airtoall/papr-eletrical/4-mill-vent/Pictures/4-mill-vent-back_parts.jpg

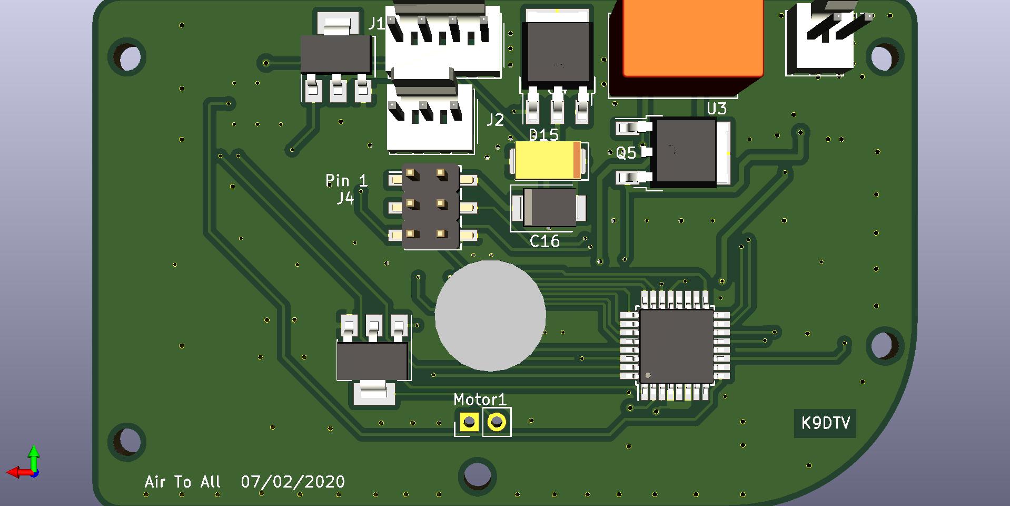
4-mill-vent/Pictures/4-mill-vent-back_parts.jpg
