airtoall/papr-eletrical/4-mill-vent/Pictures/4-mill-vent-front_parts.jpg

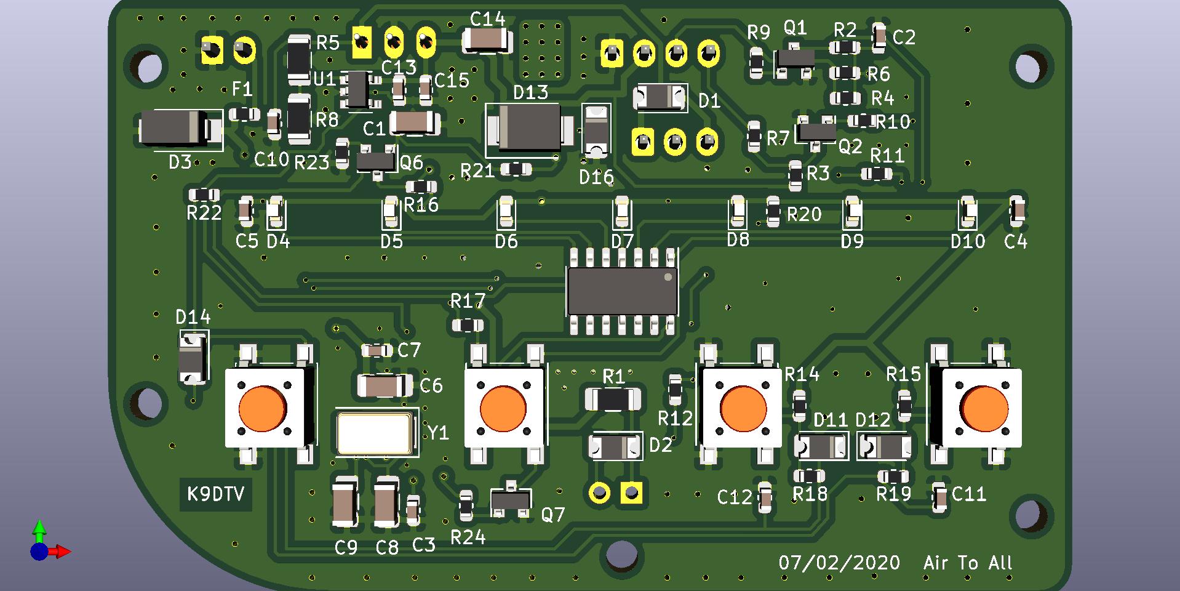
4-mill-vent/Pictures/4-mill-vent-front_parts.jpg
