airtoall/papr-eletrical/4-mill-vent/Pictures/20200725_114623.jpg

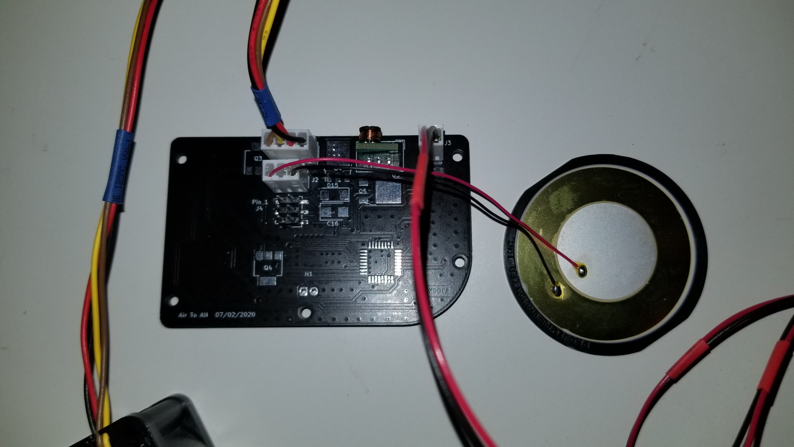
4-mill-vent/Pictures/20200725_114623.jpg
