airtoall/papr-eletrical/4-mill-vent/Pictures/20200802_105255.jpg

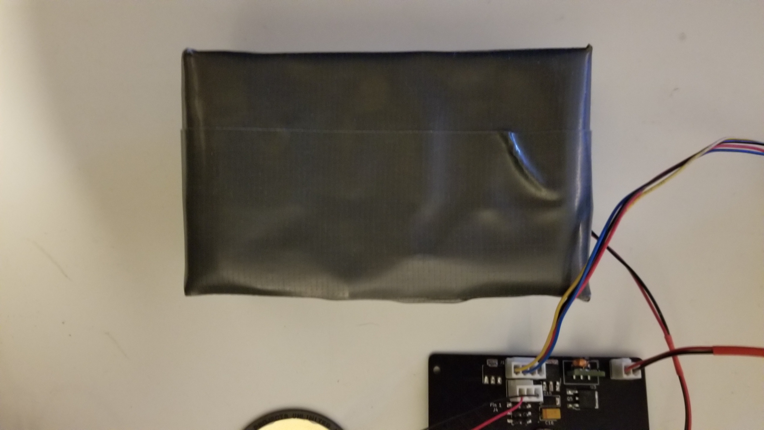
4-mill-vent/Pictures/20200802_105255.jpg
