airtoall/papr-eletrical/4-mill-vent/schematics-bom/ATA_PCBA_V3_Leadtime_Stock_Review - 12-11-2020.xlsx

Customer Reference | Vendor Part Number | Stock | Leadtime ( Weeks ) | Manufacturer Part Number | Description | Proposed Substitutes | Comments | Leadtime
ATA_0011 | 0713080492-ND | 0 | 12 | 0713080492 | CONN HEADER SMD 92POS 2.54MM | Digikey has in stock is 6-146134-5-ND, which is similar except 80 positions. |  | As of november 22, product leadtime is to be deliverded on February 2
ATA_0001 | 105-03PMFS-SC7001-ND | 0 | 6 | 105-03PMFS-SC7001 | M 10.5 CONN | Digikey Part 952-1631-ND | Proposed substitute is functionally similar. It's about 5mm larger in diameter though, so that may be a mechanical fit issue. Panel cutout for the original part is 10.0mm and the overall diameter including the hex nut is 17.3mm. Braulio called distributor for the amphenol susbtitute. | As of november 22, product leadtime is to be delivered on January 1
ATA_0040 | 296-47075-ND | 300 | 8 | TPSM84212EAB | DC DC CONVERTER 12V
ATA_0042 | VLMY1300-GS08CT-ND | 300 | 10 | VLMY1300-GS08 | LED YELLOW 0603 SMD |  | as of november 22, the leadtimes are (paste from Brent's email) january 4
ATA_0002 | 478-1471-1-ND | 500 | 12 | 12065A180JAT2A | CAP CER 18PF 50V C0G/NP0 1206
ATA_0012 | 668-1190-ND | 900 | 13 | APS4812B-LW100-R | BUZZER ELEMENT STD 1.2KHZ 50MM
ATA_0028 | RHM300ZCT-ND | 1400 | 10 | LTR18EZPJ301 | RES SMD 300 OHM 3/4W 1206 WIDE
ATA_0041 | TSM480P06CPROGCT-ND | 1500 | 20 | TSM480P06CP ROG | MOSFET P-CHANNEL 60V 20A TO252
ATA_0010 | 652-4814P-1LF-330 | 1600 | 7 | 4814P-1-331LF | RES ARRAY 7 RES 330 OHM 14SOIC
ATA_0017 | XC3086CT-ND | 1800 | 9 | ECS-160-18-23B-JTM-TR | CRYSTAL 16.0000MHZ 18PF SMD | ECS-160-18-23A-JGN-TR | Proposed substitute is the same as what's on the BOM now, just 2 pins instead of 4. Height is the same.
ATA_0025 | LM1117DTX-5.0/NOPBCT-ND | 2000 | 6 | LM1117DTX-5.0/NOPB | IC REG LINEAR 5V 800MA TO252-3
ATA_0039 | 511-TCTAL1V335M8RDKR-ND | 2900 | 8 | TCTAL1V335M8R | CAP TANT 3.3UF 20% 35V 1206
ATA_0026 | 296-51261-1-ND | 3000 | 6 | LM321LVIDBVR | IC OPAMP GP 1 CIRCUIT SOT23-5
ATA_0037 | 67-2332-1-ND | 4000 | 14 | SML-LXIL0603UPGCTR | 1.64X0.84X1.15MM TOP VIEW SMT LE
ATA_0019 | P560KBZCT-ND | 4000 | 19 | ERJ-PA3J564V | RES SMD 560K OHM 5% 1/4W 0603
ATA_0034 | RNCP1206FTD14K0CT-ND | 4500 | 18 | RNCP1206FTD14K0 | RES 14K OHM 1% 1/2W 1206
ATA_0032 | 541-2820-1-ND | 5000 | 32 | RCS0603100KJNEA | RES SMD 100K OHM 5% 1/4W 0603
ATA_0020 | RHM220KDCT-ND | 6000 | 10 | ESR03EZPJ224 | RES SMD 220K OHM 5% 1/4W 0603
ATA_0033 | 541-2814-1-ND | 7000 | 32 | RCS06031K00JNEA | RES SMD 1K OHM 5% 1/4W 0603
ATA_0035 | RNCP1206FTD75K0CT-ND | 7500 | 18 | RNCP1206FTD75K0 | RES 75K OHM 1% 1/2W 1206
ATA_0027 | 587-6340-1-ND | 8000 | 17 | LMK316AB7106MLHT | CAP CER 10UF 10V X7R 1206
ATA_0021 | RHM820KDCT-ND | 8000 | 10 | ESR03EZPJ824 | RES SMD 820K OHM 5% 1/4W 0603
ATA_0009 | 538-22-23-2042 | 10000 | 12 | 0022232042 | CONN HEADER VERT 4POS 2.54MM
ATA_0016 | 541-10KSACT-ND | 12000 | 18 | CRCW060310K0JNEAHP | RES SMD 10K OHM 5% 1/4W 0603
ATA_0036 | SMBJ5362B-TPMSCT-ND | 14000 | 12 | SMBJ5362B-TP | DIODE ZENER 28V 5W DO214AA
ATA_0008 | WM22764-ND | 15000 | 13 | 22232037 | CONN HEADER VERT 3POS 2.54MM
ATA_0014 | ATMEGA328P-AU-ND | 16000 | 9 | ATMEGA328P-AU | IC MCU 8BIT 32KB FLASH 32TQFP
ATA_0007 | WM19468-ND | 18000 | 8 | 0022232023 | CONN HEADER VERT 2POS 2.54MM
ATA_0018 | P330BZCT-ND | 19000 | 19 | ERJ-PA3J331V | RES SMD 330 OHM 5% 1/4W 0603
ATA_0038 | 399-8339-1-ND | 27000 | 7 | T491C107M006AT | CAP TANT 100UF 20% 6.3V 2312
ATA_0013 | 754-1804-1-ND | 30000 | 12 | APTD1608VBC/D | LED BLUE CLEAR CHIP SMD
ATA_0031 | PZT3904T1GOSCT-ND | 31000 | 8 | PZT3904T1G | TRANS NPN 40V 0.2A SOT223
ATA_0030 | CKN9084CT-ND | 85000 | 16 | PTS645SK43SMTR92 LFS | SWITCH TACTILE SPST-NO 0.05A 12V
ATA_0029 | MMBT3904-TP | 95000 | 12 | MMBT3904-TP | TRANS NPN 40V 0.2A SOT23
ATA_0015 | 399-1099-1-ND | 176000 | 8 | C0603C104M4RACTU | CAP CER 0.1UF 16V X7R 0603
