airtoall/papr-eletrical/4-mill-vent/schematics-bom/BOM-v1.xlsx

Part | Description | Package | Part Number | Link to part | Data Sheet
C1 | Multilayer Ceramic Capacitors MLCC - SMD/SMT 16V 0.1uF 0603 X7R 20% | SMD:C 0603 1608 Metric | C0603C104M4RACTU | https://www.mouser.com/ProductDetail/KEMET/C0603C104M4RACTU?qs=jZ42y6hXG8n1McOj%2FlAJug%3D%3D | http://ksim.kemet.com/Plots/SpicePlots.aspx
C2 | Multilayer Ceramic Capacitors MLCC - SMD/SMT 16V 0.1uF 0603 X7R 20% | SMD:C 0603 1608 Metric | C0603C104M4RACTU | https://www.mouser.com/ProductDetail/KEMET/C0603C104M4RACTU?qs=jZ42y6hXG8n1McOj%2FlAJug%3D%3D | http://ksim.kemet.com/Plots/SpicePlots.aspx
C3 | Multilayer Ceramic Capacitors MLCC - SMD/SMT 16V 0.1uF 0603 X7R 20% | SMD:C 0603 1608 Metric | C0603C104M4RACTU | https://www.mouser.com/ProductDetail/KEMET/C0603C104M4RACTU?qs=jZ42y6hXG8n1McOj%2FlAJug%3D%3D | http://ksim.kemet.com/Plots/SpicePlots.aspx
C4 | Multilayer Ceramic Capacitors MLCC - SMD/SMT 16V 0.1uF 0603 X7R 20% | SMD:C 0603 1608 Metric | C0603C104M4RACTU | https://www.mouser.com/ProductDetail/KEMET/C0603C104M4RACTU?qs=jZ42y6hXG8n1McOj%2FlAJug%3D%3D | http://ksim.kemet.com/Plots/SpicePlots.aspx
C5 | Multilayer Ceramic Capacitors MLCC - SMD/SMT 16V 0.1uF 0603 X7R 20% | SMD:C 0603 1608 Metric | C0603C104M4RACTU | https://www.mouser.com/ProductDetail/KEMET/C0603C104M4RACTU?qs=jZ42y6hXG8n1McOj%2FlAJug%3D%3D | http://ksim.kemet.com/Plots/SpicePlots.aspx
C6 | Multilayer Ceramic Capacitors MLCC - SMD/SMT 1206 10VDC 10uF 20% X7R | SMD:C 1206 3216 Metric | LMK316AB7106MLHT | https://www.mouser.com/ProductDetail/Taiyo-Yuden/LMK316AB7106MLHT | https://www.mouser.com/datasheet/2/396/taiyo_yuden_12132018_mlcc11_hq_e-1510082.pdf
C7 | Multilayer Ceramic Capacitors MLCC - SMD/SMT 16V 0.1uF 0603 X7R 20% | SMD:C 0603 1608 Metric | C0603C104M4RACTU | https://www.mouser.com/ProductDetail/KEMET/C0603C104M4RACTU?qs=jZ42y6hXG8n1McOj%2FlAJug%3D%3D | http://ksim.kemet.com/Plots/SpicePlots.aspx
C8 | Multilayer Ceramic Capacitors MLCC - SMD/SMT 18pF NPO | SMD:C 1206 3216 Metric | 1206Y0160180FFT | https://www.mouser.com/ProductDetail/Knowles-Syfer/1206Y0160180FFT | https://www.mouser.com/datasheet/2/218/IECQ-CECCDatasheet-1509637.pdf
C9 | Multilayer Ceramic Capacitors MLCC - SMD/SMT 18pF NPO | SMD:C 1206 3216 Metric | 1206Y0160180FFT | https://www.mouser.com/ProductDetail/Knowles-Syfer/1206Y0160180FFT | https://www.mouser.com/datasheet/2/218/IECQ-CECCDatasheet-1509637.pdf
C10 | Multilayer Ceramic Capacitors MLCC - SMD/SMT 16V 0.1uF 0603 X7R 20% | SMD:C 0603 1608 Metric | C0603C104M4RACTU | https://www.mouser.com/ProductDetail/KEMET/C0603C104M4RACTU?qs=jZ42y6hXG8n1McOj%2FlAJug%3D%3D | http://ksim.kemet.com/Plots/SpicePlots.aspx
C11 | Multilayer Ceramic Capacitors MLCC - SMD/SMT 16V 0.1uF 0603 X7R 20% | SMD:C 0603 1608 Metric | C0603C104M4RACTU | https://www.mouser.com/ProductDetail/KEMET/C0603C104M4RACTU?qs=jZ42y6hXG8n1McOj%2FlAJug%3D%3D | http://ksim.kemet.com/Plots/SpicePlots.aspx
C12 | Multilayer Ceramic Capacitors MLCC - SMD/SMT 16V 0.1uF 0603 X7R 20% | SMD:C 0603 1608 Metric | C0603C104M4RACTU | https://www.mouser.com/ProductDetail/KEMET/C0603C104M4RACTU?qs=jZ42y6hXG8n1McOj%2FlAJug%3D%3D | http://ksim.kemet.com/Plots/SpicePlots.aspx
C13 | Solid SMD Tantalum Capacitors - 3.3uf 36V | SMD:C 1206 3216 Metric | TCTAL1V335M8R | https://www.mouser.com/ProductDetail/ROHM-Semiconductor/TCTAL1V335M8R | https://www.mouser.com/datasheet/2/348/tct_al-e-1874581.pdf
C14 | Multilayer Ceramic Capacitors MLCC - SMD/SMT 1206 10VDC 10uF 20% X7R | SMD:C 1206 3216 Metric | LMK316AB7106MLHT | https://www.mouser.com/ProductDetail/Taiyo-Yuden/LMK316AB7106MLHT | https://www.mouser.com/datasheet/2/396/taiyo_yuden_12132018_mlcc11_hq_e-1510082.pdf
C15 | Multilayer Ceramic Capacitors MLCC - SMD/SMT 16V 0.1uF 0603 X7R 20% | SMD:C 0603 1608 Metric | C0603C104M4RACTU | https://www.mouser.com/ProductDetail/KEMET/C0603C104M4RACTU?qs=jZ42y6hXG8n1McOj%2FlAJug%3D%3D | http://ksim.kemet.com/Plots/SpicePlots.aspx
C16 | Tantalum Capacitors - Solid SMD 6.3V 100.uF 2312 20% ESR=900mOhms | SMD:CP-EIA 6032-15 | T491C107M006AT | https://www.mouser.com/ProductDetail/KEMET/T491C107M006AT?qs=qfhfvpM3tgiD6Stt3RzjFA%3D%3D | https://www.mouser.com/datasheet/2/212/1/KEM_T2005_T491-1093550.pdf
C17 | Multilayer Ceramic Capacitors MLCC - SMD/SMT 16V 0.1uF 0603 X7R 20% | SMD:C 0603 1608 Metric | C0603C104M4RACTU | https://www.mouser.com/ProductDetail/KEMET/C0603C104M4RACTU?qs=jZ42y6hXG8n1McOj%2FlAJug%3D%3D | http://ksim.kemet.com/Plots/SpicePlots.aspx
D1 | General Purpose, Power, Switching Switching diode 400 mW | SMD:D SOD-123F | 1N914BW RH | https://www.mouser.com/ProductDetail/Taiwan-Semiconductor/1N914BW-RH?qs=SikLhao2tv9CkM7MAcUvqA%3D%3D | https://www.mouser.com/datasheet/2/395/1N4148W_SERIES_K1804-1519318.pdf
D2 | General Purpose, Power, Switching Switching diode 400 mW | SMD:D SOD-123F | 1N914BW RH | https://www.mouser.com/ProductDetail/Taiwan-Semiconductor/1N914BW-RH?qs=SikLhao2tv9CkM7MAcUvqA%3D%3D | https://www.mouser.com/datasheet/2/395/1N4148W_SERIES_K1804-1519318.pdf
D3 | Zener 28V 5W | DO-214AA-2 | SMBJ5362B-TP | https://www.mouser.com/ProductDetail/Micro-Commercial-Components-MCC/SMBJ5362B-TP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 | https://www.mouser.com/datasheet/2/258/SMBJ5338B-SMBJ5388B(SMB)-V1-1626682.pdf
D4 | RED | SMD:LED 0603 1608 Metric | KS DELPS1.22-TIVH-68-H3Q4 | https://www.mouser.com/ProductDetail/OSRAM-Opto-Semiconductors/KS-DELPS122-TIVH-68-H3Q4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 | https://www.mouser.com/datasheet/2/50/SM0603UWC-880813.pdf
D5 | YELLOW | SMD:LED 0603 1608 Metric | VLMY1300-GS08 | https://www.mouser.com/ProductDetail/Vishay-Semiconductors/VLMY1300-GS08?qs=uoVnq4yU%252B9LyY5CVnohKmg%3D%3D | https://www.mouser.com/datasheet/2/427/vlmo1300-1766934.pdf
D6 | GREEN | SMD:LED 0603 1608 Metric | SML-LXIL0603UPGCTR | https://www.mouser.com/ProductDetail/Lumex/SML-LXIL0603UPGCTR?qs=gZXFycFWdAOIg5vFcGcioA%3D%3D | https://www.mouser.com/datasheet/2/244/SML-LXIL0603UPGCTR-1530140.pdf
D7 | WHITE | SMD:LED 0603 1608 Metric | SM0603UWC | https://www.mouser.com/ProductDetail/Bivar/SM0603UWC?qs=jaLxTFIJCitV8o3XQorFYg%3D%3D | https://www.mouser.com/datasheet/2/50/SM0603UWC-880813.pdf
D8 | BLUE | SMD:LED 0603 1608 Metric | APTD1608VBC/D | https://www.mouser.com/ProductDetail/Kingbright/APTD1608VBC-D?qs=Rt2YTNbomKgKG1skWlFZLw%3D%3D | https://www.mouser.com/datasheet/2/216/APTD1608VBC-D-472161.pdf
D9 | BLUE | SMD:LED 0603 1608 Metric | APTD1608VBC/D | https://www.mouser.com/ProductDetail/Kingbright/APTD1608VBC-D?qs=Rt2YTNbomKgKG1skWlFZLw%3D%3D | https://www.mouser.com/datasheet/2/216/APTD1608VBC-D-472161.pdf
D10 | BLUE | SMD:LED 0603 1608 Metric | APTD1608VBC/D | https://www.mouser.com/ProductDetail/Kingbright/APTD1608VBC-D?qs=Rt2YTNbomKgKG1skWlFZLw%3D%3D | https://www.mouser.com/datasheet/2/216/APTD1608VBC-D-472161.pdf
D11 | General Purpose, Power, Switching Switching diode 400 mW | SMD:D SOD-123F | 1N914BW RH | https://www.mouser.com/ProductDetail/Taiwan-Semiconductor/1N914BW-RH?qs=SikLhao2tv9CkM7MAcUvqA%3D%3D | https://www.mouser.com/datasheet/2/395/1N4148W_SERIES_K1804-1519318.pdf
D12 | General Purpose, Power, Switching Switching diode 400 mW | SMD:D SOD-123F | 1N914BW RH | https://www.mouser.com/ProductDetail/Taiwan-Semiconductor/1N914BW-RH?qs=SikLhao2tv9CkM7MAcUvqA%3D%3D | https://www.mouser.com/datasheet/2/395/1N4148W_SERIES_K1804-1519318.pdf
D13 | Rectifiers SMA,1A,400V,GP | DO-214AC-2 | FM4004-W-S-NT | https://www.mouser.com/ProductDetail/Rectron/FM4004-W-S-NT | https://www.mouser.com/datasheet/2/345/fm4001-fm4007-1113844.pdf
D14 | General Purpose, Power, Switching Switching diode 400 mW | SMD:D SOD-123F | 1N914BW RH | https://www.mouser.com/ProductDetail/Taiwan-Semiconductor/1N914BW-RH?qs=SikLhao2tv9CkM7MAcUvqA%3D%3D | https://www.mouser.com/datasheet/2/395/1N4148W_SERIES_K1804-1519318.pdf
D15 | Rectifiers SMA,1A,400V,GP | DO-214AC-2 | FM4004-W-S-NT | https://www.mouser.com/ProductDetail/Rectron/FM4004-W-S-NT | https://www.mouser.com/datasheet/2/345/fm4001-fm4007-1113844.pdf
D16 | General Purpose, Power, Switching Switching diode 400 mW | SMD:D SOD-123F | 1N914BW RH | https://www.mouser.com/ProductDetail/Taiwan-Semiconductor/1N914BW-RH?qs=SikLhao2tv9CkM7MAcUvqA%3D%3D | https://www.mouser.com/datasheet/2/395/1N4148W_SERIES_K1804-1519318.pdf
Q3 | Bipolar Transistors - BJT 0.2A 40V 1.5W NPN | SOT-223-4 | PZT3904T1G | https://www.mouser.com/ProductDetail/ON-Semiconductor/PZT3904T1G?qs=xZq1yRCsb1eC3ukwvyKrig%3D%3D | https://www.mouser.com/datasheet/2/308/PZT3904T1-D-1814818.pdf
Q4 | Bipolar Transistors - BJT 0.2A 40V 1.5W NPN | SOT-223-4 | PZT3904T1G | https://www.mouser.com/ProductDetail/ON-Semiconductor/PZT3904T1G?qs=xZq1yRCsb1eC3ukwvyKrig%3D%3D | https://www.mouser.com/datasheet/2/308/PZT3904T1-D-1814818.pdf
Q5 | MOSFET -60V, -20A, Single P-Channel Power MOSFET | TO-252-3 | TSM480P06CP ROG | https://www.mouser.com/ProductDetail/Taiwan-Semiconductor/TSM480P06CP-ROG?qs=5aG0NVq1C4wfz7PIdqY8hA%3D%3D | https://www.mouser.com/datasheet/2/395/TSM480P06_D14-1118171.pdf
Q6 | Bipolar Transistors - BJT 40V | SMD: SOT-23-3 | MMBT3904-TP | https://www.mouser.com/ProductDetail/Micro-Commercial-Components-MCC/MMBT3904-TP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 | https://www.mouser.com/datasheet/2/258/MMBT3904(SOT-23)-V1-1626391.pdf
Q7 | Bipolar Transistors - BJT 40V | SMD: SOT-23-3 | MMBT3904-TP | https://www.mouser.com/ProductDetail/Micro-Commercial-Components-MCC/MMBT3904-TP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 | https://www.mouser.com/datasheet/2/258/MMBT3904(SOT-23)-V1-1626391.pdf
U1 | Operational Amplifiers - 1-Channel industry standard low voltage | 5-SOT-23 | LM321MFX/NOPB
U2 | MCU 32KB In-system Flash 20MHz 1.8V-5.5V | TQFP-32 | ATMEGA328P-AU | https://www.mouser.com/ProductDetail/Microchip-Technology-Atmel/ATMEGA328P-AU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 | https://www.mouser.com/datasheet/2/268/Atmel-8271-8-bit-AVR-Microcontroller-ATmega48A-48P-1315288.pdf
U3 | Non-Isolated DC/DC Converters 1.5A, 28V Input, 12V Output MODULE | TO-220 | TPSM84212EAB | https://www.mouser.com/ProductDetail/Texas-Instruments/TPSM84212EAB | https://www.ti.com/lit/ds/symlink/tpsm84212.pdf?HQS=TI-null-null-mousermode-df-pf-null-wwe&DCM=yes&distId=26
U4 | LDO Voltage Regulators 800mA LDO Linear Reg | TO-252-3 | LM1117DTX-5.0/NOPB | https://www.mouser.com/ProductDetail/Texas-Instruments/LM1117DTX-50-NOPB?qs=X1J7HmVL2ZGetRa19U64lA%3D%3D | https://www.ti.com/general/docs/suppproductinfo.tsp?distId=26
Y1 | Crystals 16MHz 18pF ESR 50 20ppm -20C +70C | 6 mm x 3.5 mm | ECS-160-18-23B-JTM-TR | https://www.mouser.com/ProductDetail/ECS/ECS-160-18-23B-JTM-TR?qs=9r4v7xj2LnkNXR3nvzv5Lw%3D%3D
R1 | 300 Ohms, 750 mW. 3/4 W, 5 %, 200 PPM / C | 0612, 1632 | LTR18EZPJ301 | https://www.mouser.com/ProductDetail/ROHM-Semiconductor/LTR18EZPJ301 | https://www.mouser.com/datasheet/2/348/ltr-e-1139145.pdf
R5 | Thin Film Resistors - SMD 43.2kOhm,1206,1%,10p pm,250mW,150V | SMD:C 1206 3216 Metric | RN73H2BTTD4322F100 | https://www.mouser.com/ProductDetail/KOA-Speer/RN73H2BTTD4322F100 | https://www.mouser.com/datasheet/2/219/RN73H-1843478.pdf
R6 | Thick Film Resistors - SMD 1/4watt 10Kohms 5% | SMD:C 0603 1608 Metric | CRCW060310K0JNEAHP | https://www.mouser.com/ProductDetail/Vishay-Dale/CRCW060310K0JNEAHP?qs=k2%2FDWSARqgH8Om6O4X312A%3D%3D | https://www.mouser.com/datasheet/2/427/crcwhpe3-1713858.pdf
R7 | Thick Film Resistors - SMD 330ohm 5% | SMD:C 0603 1608 Metric | ERJ-PA3J331V | https://www.mouser.com/ProductDetail/Panasonic/ERJ-PA3J331V?qs=BzJM0faLVqWDr5skovv6aw%3D%3D | https://www.mouser.com/datasheet/2/315/AOA0000C331-1141874.pdf
R8 | Thin Film Resistors - SMD 8.06kOhm,1206,1%,50p pm,250mW,150V | SMD:C 1206 3216 Metric | RN73H2BTTD8061F50 | https://www.mouser.com/ProductDetail/KOA-Speer/RN73H2BTTD8061F50 | https://www.mouser.com/datasheet/2/219/RN73H-1843478.pdf
R9 | Thick Film Resistors - SMD 0.25watt 1Kohms 5% 200ppm | SMD:C 0603 1608 Metric | RCS06031K00JNEA | https://www.mouser.com/ProductDetail/Vishay-Dale/RCS06031K00JNEA?qs=NKmfXavxMawsM4RhZCFdQg%3D%3D | https://www.mouser.com/datasheet/2/427/rcse3-1761771.pdf
R11 | Thick Film Resistors - SMD 0.25watt 1Kohms 5% 200ppm | SMD:C 0603 1608 Metric | RCS06031K00JNEA | https://www.mouser.com/ProductDetail/Vishay-Dale/RCS06031K00JNEA?qs=NKmfXavxMawsM4RhZCFdQg%3D%3D | https://www.mouser.com/datasheet/2/427/rcse3-1761771.pdf
R12 | Thick Film Resistors - SMD 0.25watt 1Kohms 5% 200ppm | SMD:C 0603 1608 Metric | RCS06031K00JNEA | https://www.mouser.com/ProductDetail/Vishay-Dale/RCS06031K00JNEA?qs=NKmfXavxMawsM4RhZCFdQg%3D%3D | https://www.mouser.com/datasheet/2/427/rcse3-1761771.pdf
R13 | Resistor Networks & Arrays 330ohm 2% 14 Pin | SOIC-14 3.9x8.7x1.27mm | 4814P-1-331LF | https://www.mouser.com/ProductDetail/Bourns/4814P-1-331LF | https://www.mouser.com/datasheet/2/54/4800P-777115.pdf
R14 | Thick Film Resistors - SMD 0.25watt 100Kohms 5% 200ppm | SMD:C 0603 1608 Metric | RCS0603100KJNEA | https://www.mouser.com/ProductDetail/Vishay-Dale/RCS0603100KJNEA?qs=NKmfXavxMaxmotuD1habtA%3D%3D | https://www.mouser.com/datasheet/2/427/rcse3-1761771.pdf
R15 | Thick Film Resistors - SMD 0.25watt 100Kohms 5% 200ppm | SMD:C 0603 1608 Metric | RCS0603100KJNEA | https://www.mouser.com/ProductDetail/Vishay-Dale/RCS0603100KJNEA?qs=NKmfXavxMaxmotuD1habtA%3D%3D | https://www.mouser.com/datasheet/2/427/rcse3-1761771.pdf
R16 | Thick Film Resistors - SMD 0603 560Kohm 5% Anti-Surge AEC-Q200 | SMD:C 0603 1608 Metric | ERJ-PA3J564V | https://www.mouser.com/ProductDetail/Panasonic/ERJ-PA3J564V?qs=BzJM0faLVqU%252BnfZdwqH5EQ%3D%3D | https://www.mouser.com/datasheet/2/315/AOA0000C331-1141874.pdf
R17 | Thick Film Resistors - SMD 0.25watt 100Kohms 5% 200ppm | SMD:C 0603 1608 Metric | RCS0603100KJNEA | https://www.mouser.com/ProductDetail/Vishay-Dale/RCS0603100KJNEA?qs=NKmfXavxMaxmotuD1habtA%3D%3D | https://www.mouser.com/datasheet/2/427/rcse3-1761771.pdf
R18 | Thick Film Resistors - SMD 1/4watt 10Kohms 5% | SMD:C 0603 1608 Metric | CRCW060310K0JNEAHP | https://www.mouser.com/ProductDetail/Vishay-Dale/CRCW060310K0JNEAHP?qs=k2%2FDWSARqgH8Om6O4X312A%3D%3D | https://www.mouser.com/datasheet/2/427/crcwhpe3-1713858.pdf
R19 | Thick Film Resistors - SMD 1/4watt 10Kohms 5% | SMD:C 0603 1608 Metric | CRCW060310K0JNEAHP | https://www.mouser.com/ProductDetail/Vishay-Dale/CRCW060310K0JNEAHP?qs=k2%2FDWSARqgH8Om6O4X312A%3D%3D | https://www.mouser.com/datasheet/2/427/crcwhpe3-1713858.pdf
R20 | Thick Film Resistors - SMD 1/4watt 10Kohms 5% | SMD:C 0603 1608 Metric | CRCW060310K0JNEAHP | https://www.mouser.com/ProductDetail/Vishay-Dale/CRCW060310K0JNEAHP?qs=k2%2FDWSARqgH8Om6O4X312A%3D%3D | https://www.mouser.com/datasheet/2/427/crcwhpe3-1713858.pdf
R21 | Thick Film Resistors - SMD 820Kohm 5% | SMD:C 0603 1608 Metric | ESR03EZPJ824 | https://www.mouser.com/ProductDetail/ROHM-Semiconductor/ESR03EZPJ824?qs=493kPxzlxfJAnMYOiiyG%2Fg%3D%3D | https://www.mouser.com/datasheet/2/348/esr-e-1139161.pdf
R22 | Thick Film Resistors - SMD 220Kohm 5% | SMD:C 0603 1608 Metric | ESR03EZPJ224 | https://www.mouser.com/ProductDetail/ROHM-Semiconductor/ESR03EZPJ224?qs=493kPxzlxfKIu%252BBXUS2v9w%3D%3D | https://www.mouser.com/datasheet/2/348/esr-e-1139161.pdf
R23 | Thick Film Resistors - SMD 560Kohm 5% | SMD:C 0603 1608 Metric | ERJ-PA3J564V | https://www.mouser.com/ProductDetail/Panasonic/ERJ-PA3J564V?qs=BzJM0faLVqU%252BnfZdwqH5EQ%3D%3D | https://www.mouser.com/datasheet/2/315/AOA0000C331-1141874.pdf
SW1 | Tactile Switches SWITCH TACTILE | PTS645 | PTS645SK43SMTR92LFS | https://www.mouser.com/ProductDetail/CK/PTS645SK43SMTR92LFS?qs=UxeAxwACbqlWa%2Fy4o%252BzfBw%3D%3D | https://www.mouser.com/datasheet/2/60/pts645-1841767.pdf
SW2 | Tactile Switches SWITCH TACTILE | PTS645 | PTS645SK43SMTR92LFS | https://www.mouser.com/ProductDetail/CK/PTS645SK43SMTR92LFS?qs=UxeAxwACbqlWa%2Fy4o%252BzfBw%3D%3D | https://www.mouser.com/datasheet/2/60/pts645-1841767.pdf
SW3 | Tactile Switches SWITCH TACTILE | PTS645 | PTS645SK43SMTR92LFS | https://www.mouser.com/ProductDetail/CK/PTS645SK43SMTR92LFS?qs=UxeAxwACbqlWa%2Fy4o%252BzfBw%3D%3D | https://www.mouser.com/datasheet/2/60/pts645-1841767.pdf
SW4 | Tactile Switches SWITCH TACTILE | PTS645 | PTS645SK43SMTR92LFS | https://www.mouser.com/ProductDetail/CK/PTS645SK43SMTR92LFS?qs=UxeAxwACbqlWa%2Fy4o%252BzfBw%3D%3D | https://www.mouser.com/datasheet/2/60/pts645-1841767.pdf
J1 | Headers & Wire Housings KK 100 Hdr FrLk Vert 04 Ckt Tin |  | 22-23-2042 | https://www.mouser.com/ProductDetail/Molex/22-23-2042?qs=52ipEG6BoUGnVIQV2y3Jgg%3D%3D | https://www.mouser.com/datasheet/2/276/022232042_sd-590120.pdf
J2 | Headers & Wire Housings KK 100 Hdr FrLk Vert 03 Ckt Tin |  | 22-23-2037 | https://www.mouser.com/ProductDetail/Molex/22-23-2037?qs=52ipEG6BoUGgCTv8s5iZJA%3D%3D | https://www.mouser.com/datasheet/2/276/022232037_sd-589157.pdf
J3 | Headers & Wire Housings KK 100 Hdr FrLk Vert 02 Ckt Tin |  | 22-23-2023 | https://www.mouser.com/ProductDetail/Molex/22-23-2023?qs=52ipEG6BoUHegR7NRmymbQ%3D%3D | https://www.mouser.com/datasheet/2/276/022232023_sd-590068.pdf
J4 | Headers & Wire Housings CGrid SMT Bkwy Hdr Tin 92Ckt Tubew/VC | MAKES 15 HEADERS | 71308-0492 | https://www.mouser.com/ProductDetail/Molex/71308-0492 | https://www.mouser.com/datasheet/2/276/015911060_sd-592943.pdf
F1 | 1a
 | Not Parts of PCB
J5
J6 |  |  | 105-03PMFS-SC7001 | https://www.mouser.com/ProductDetail/Amphenol-LTW/105-03PMFS-SC7001?qs=hVQAaAP6BjvJPDNwHAkOdg%3D%3D | https://www.mouser.com/datasheet/2/18/105-03PMFS-SC7001-1281236.pdf
J7
J8 | Headers & Wire Housings HSG 2P W/RAMP/RIBS |  | 22-01-3027 | https://www.mouser.com/ProductDetail/Molex/22-01-3027?qs=cRUT3GdJqnwywyFd19%252BSsA%3D%3D | https://www.mouser.com/datasheet/2/276/0022013027_CRIMP_HOUSINGS-158305.pdf
J9
J10 | Headers & Wire Housings HSG 4P W/RAMP/RIBS |  | 22-01-3047 | https://www.mouser.com/ProductDetail/Molex/22-01-3047 | https://www.mouser.com/datasheet/2/276/0022013047_CRIMP_HOUSINGS-158509.pdf
J11 |  |  | 105-03PMFS-SC7001 | https://www.mouser.com/ProductDetail/Amphenol-LTW/105-03PMFS-SC7001?qs=hVQAaAP6BjvJPDNwHAkOdg%3D%3D | https://www.mouser.com/datasheet/2/18/105-03PMFS-SC7001-1281236.pdf
J12 |  |  | 105-03PMFS-SC7001 | https://www.mouser.com/ProductDetail/Amphenol-LTW/105-03PMFS-SC7001?qs=hVQAaAP6BjvJPDNwHAkOdg%3D%3D | https://www.mouser.com/datasheet/2/18/105-03PMFS-SC7001-1281236.pdf
J13 | Headers & Wire Housings HSG 3P W/RAMP/RIBS |  | 22-01-3037 | https://www.mouser.com/ProductDetail/Molex/22-01-3037?qs=cRUT3GdJqnw5IA1z0J2xqA%3D%3D | https://www.mouser.com/datasheet/2/276/0022013037_CRIMP_HOUSINGS-158306.pdf
BT1 | six(6) cells in series 18650 or 18650 6S2P highest current rating
BT2 | six(6) cells in series
Charger
 | CONN 22-30AWG CRIMP TIN | pins for molex | 08-50-0114 | https://www.mouser.com/ProductDetail/Molex/08-50-0114 | https://www.mouser.com/datasheet/2/276/0008500114_CRIMP_TERMINALS-227200.pdf
Buzz1 | Speakers & Transducers 1200 Hz 30 Vp-p | Chassie Mount | APS4812B-LW100-R | https://www.mouser.com/ProductDetail/PUI-Audio/APS4812B-LW100-R | https://www.mouser.com/datasheet/2/334/APS4812B-LW100-R-17217.pdf
Motor1 | DC Motor Vibration, ERM 10000 RPM 3VDC | Chassie Mount | 316040004 | https://www.digikey.com/product-detail/en/seeed-technology-co-ltd/316040004/1597-1245-ND/5487673 | https://media.digikey.com/pdf/Data%20Sheets/Seeed%20Technology/1027_Spec.pdf
 | Charge Conntroller |  | HX-6S-12A
