airtoall/papr-eletrical/4-mill-vent/schematics-bom/BATT_MONITOR-added-v2.JPG

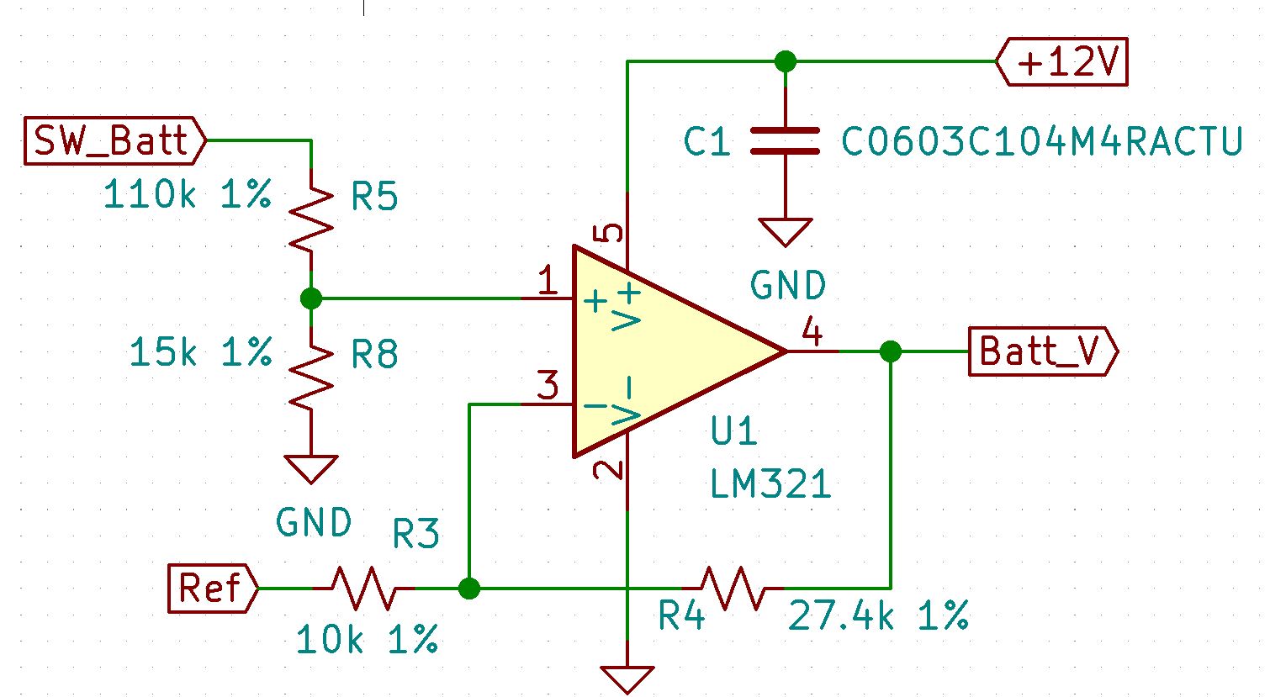
4-mill-vent/schematics-bom/BATT_MONITOR-added-v2.JPG
