airtoall/papr-eletrical/4-mill-vent/Step Files/4-mill-vent_FIRST-COMPLETE v1.step

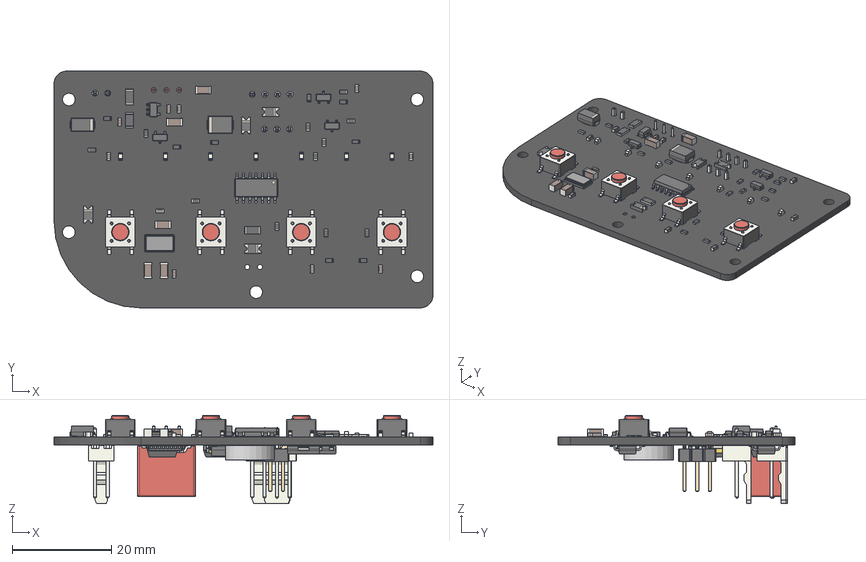
[picture p12: CAD file, 2020-07-11]
4-mill-vent/Step Files/4-mill-vent_FIRST-COMPLETE v1.step
76.2 x 47.6 x 17.7 mm
