airtoall/papr-eletrical/4-mill-vent/Step Files/motor v1.step

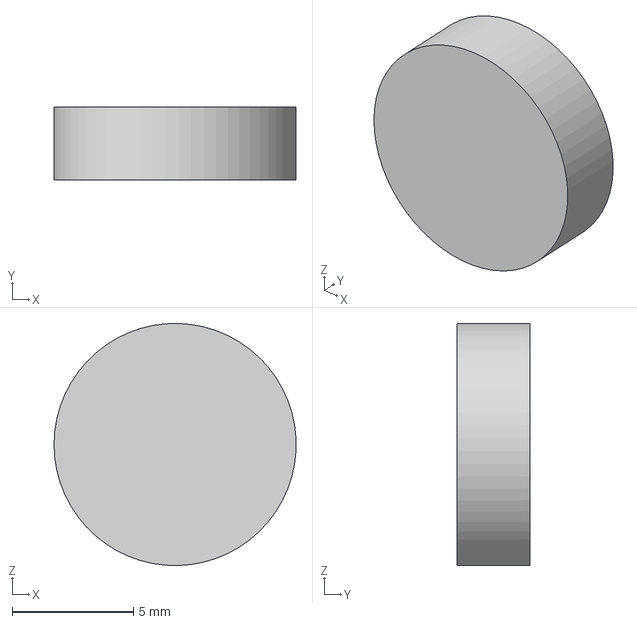
[picture p13: CAD file, 2020-07-06]
4-mill-vent/Step Files/motor v1.step
9.99 x 3.00 x 10.00 mm
