airtoall/papr-eletrical/(list of files, cad)

Other CAD files:
4-mill-vent/Step Files/4-mill-vent.step
