airtoall/papr-eletrical/4-mill-vent/Assembly Drawings with error/3-PIN-CONNECTOR WIRE.pdf

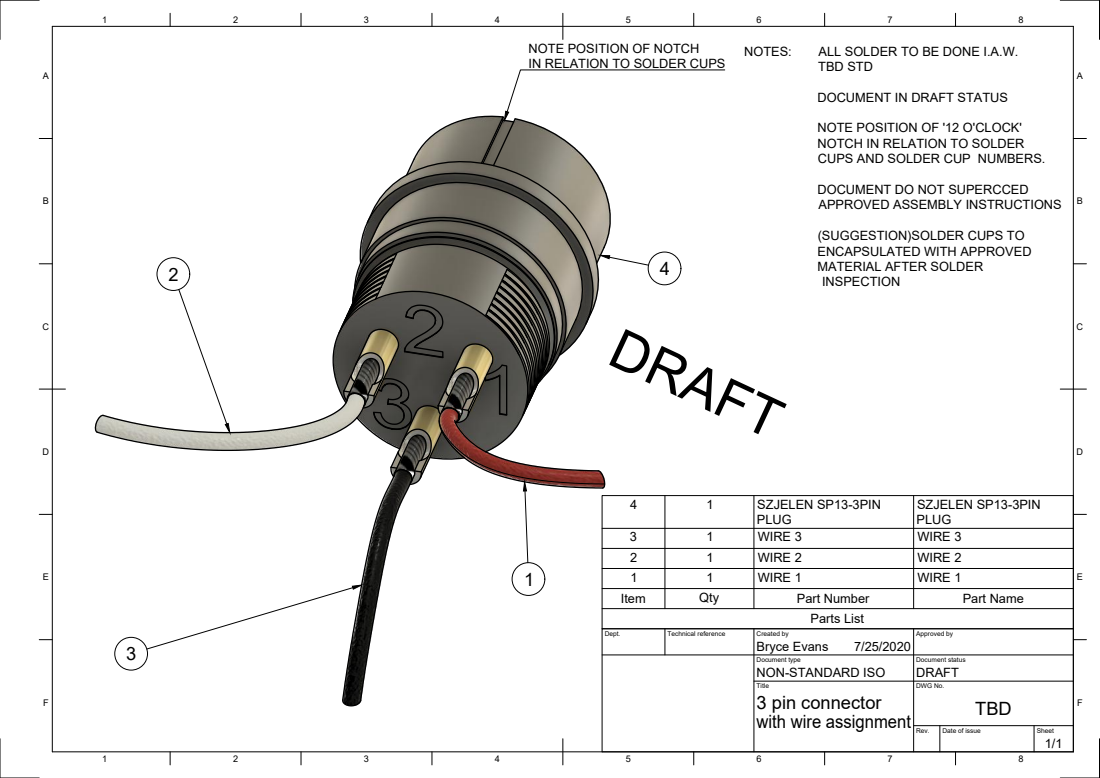
[picture p14: page 1]
8 BCDEF; ABCDEF; Parts List; PLUG 1 3; NOTES:; ALL SOLDER TO BE DONE I.A.W.; TBD STD

NOTE POSITION OF NOTCH
IN RELATION TO SOLDER CUPS

DOCUMENT IN DRAFT STATUS

NOTE POSITION OF '12 O'CLOCK'
NOTCH IN RELATION TO SOLDER
CUPS AND SOLDER CUP NUMBERS.

DOCUMENT DO NOT SUPERCCED
APPROVED ASSEMBLY INSTRUCTIONS

(SUGGESTION)SOLDER CUPS TO
ENCAPSULATED WITH APPROVED
MATERIAL AFTER SOLDER
INSPECTION

Item | Qty 1 1 1 1 | SZJELEN SP13-3PIN WIRE 1 WIRE 2 WIRE 3 Part Number | WIRE 1 2 WIRE 2 3 WIRE 3 4 Part Name 1

PLUG | SZJELEN SP13-3PIN

Dept. | Technical reference | Created by Bryce Evans 7/25/2020 | Approved by

Document type NON-STANDARD ISO | Document status DRAFT

Title 3 pin connector with wire assignment | DWG No. TBD

Rev. | Date of issue | Sheet 1/1
