airtoall/papr-eletrical/4-mill-vent/Assembly Drawings with error/EXPLODED BATTERY v5.pdf

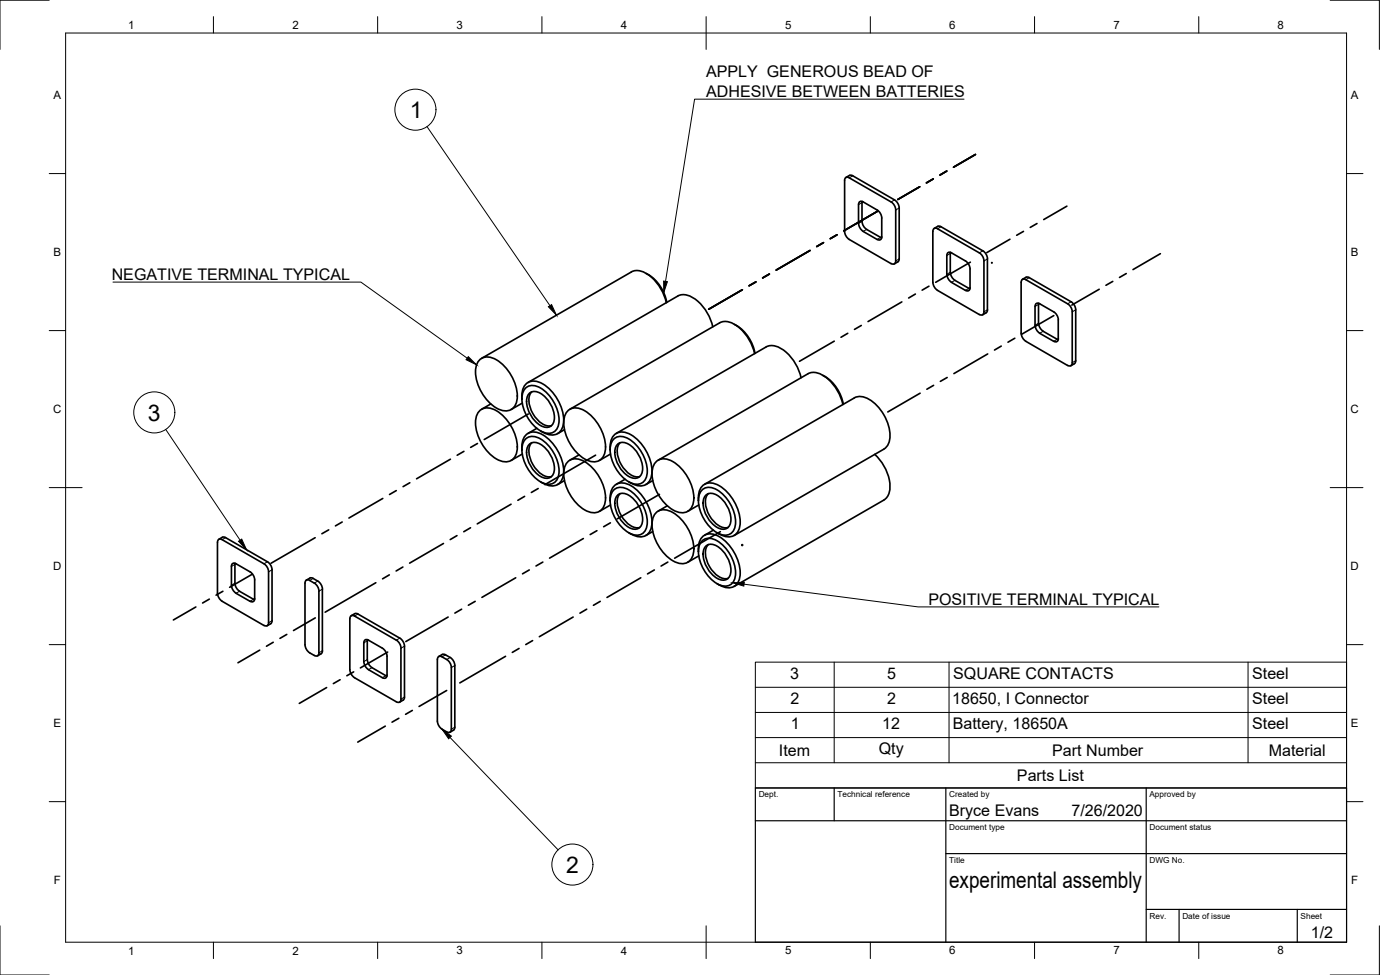
[picture p15: page 1]
Parts List

APPLY GENEROUS BEAD OF
ADHESIVE BETWEEN BATTERIES

NEGATIVE TERMINAL TYPICAL

POSITIVE TERMINAL TYPICAL

3 | 5 | SQUARE CONTACTS | Steel
2 | 2 | 18650, I Connector | Steel
1 | 12 | Battery, 18650A | Steel
Item | Qty | Part Number | Material

Dept. | Technical reference | Created by Bryce Evans 7/26/2020 | Approved by

Document type | Document status

Title experimental assembly | DWG No.

Rev. | Date of issue | Sheet 1/2

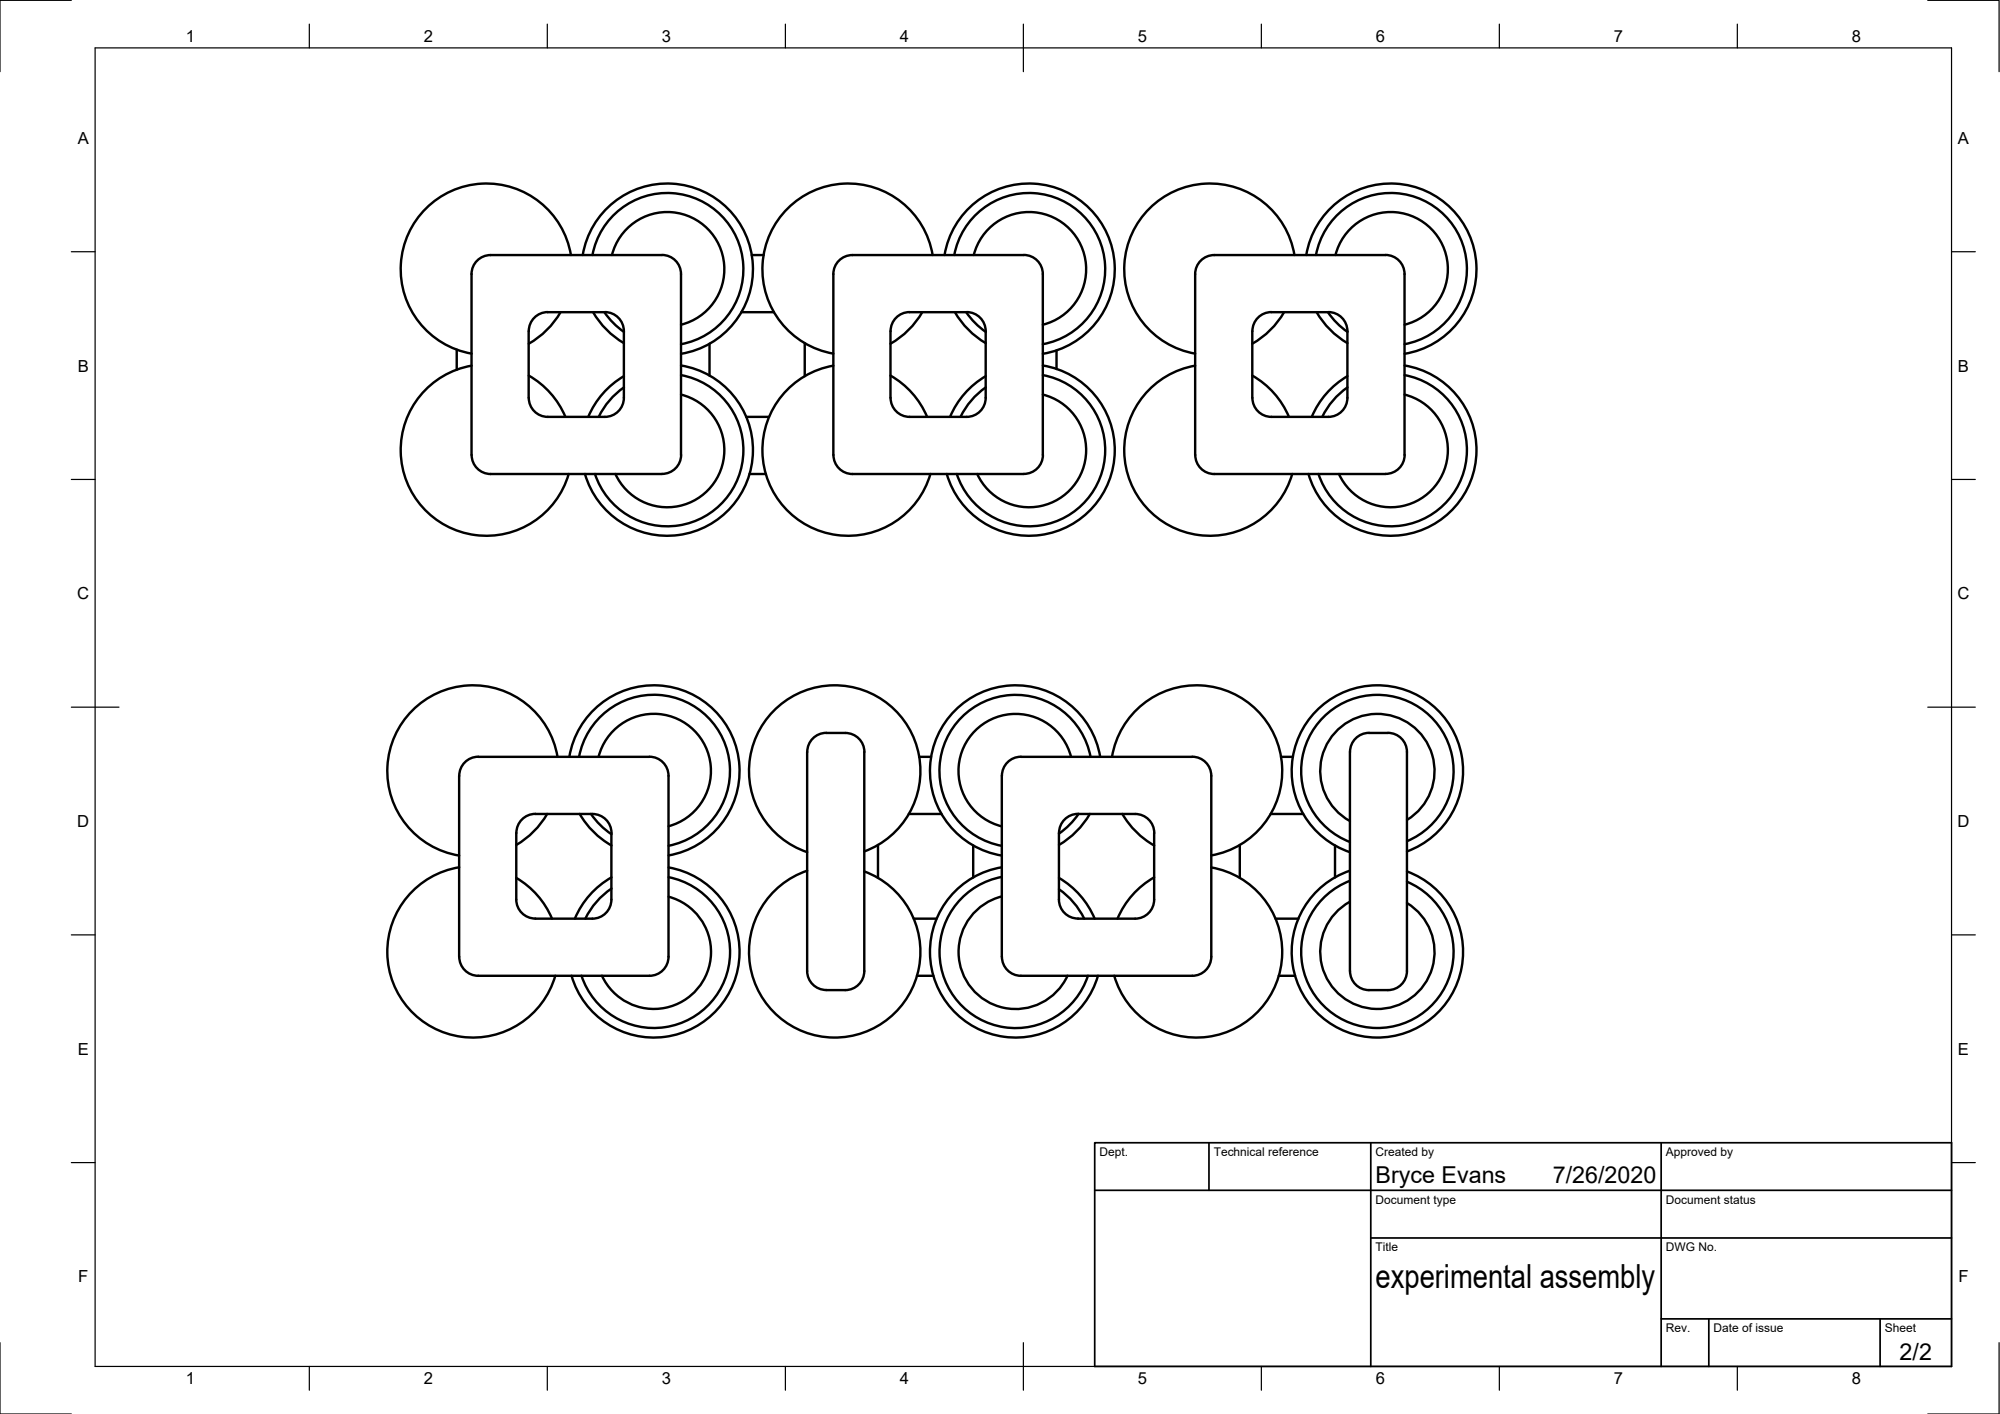
[picture p16: page 2]

Dept. | Technical reference | Created by Bryce Evans 7/26/2020 | Approved by

Document type | Document status

Title experimental assembly | DWG No.

Rev. | Date of issue | Sheet 2/2
