airtoall/papr-eletrical/4-mill-vent/Assembly Drawings with error/HS-6S-12A DRAWING v1.pdf

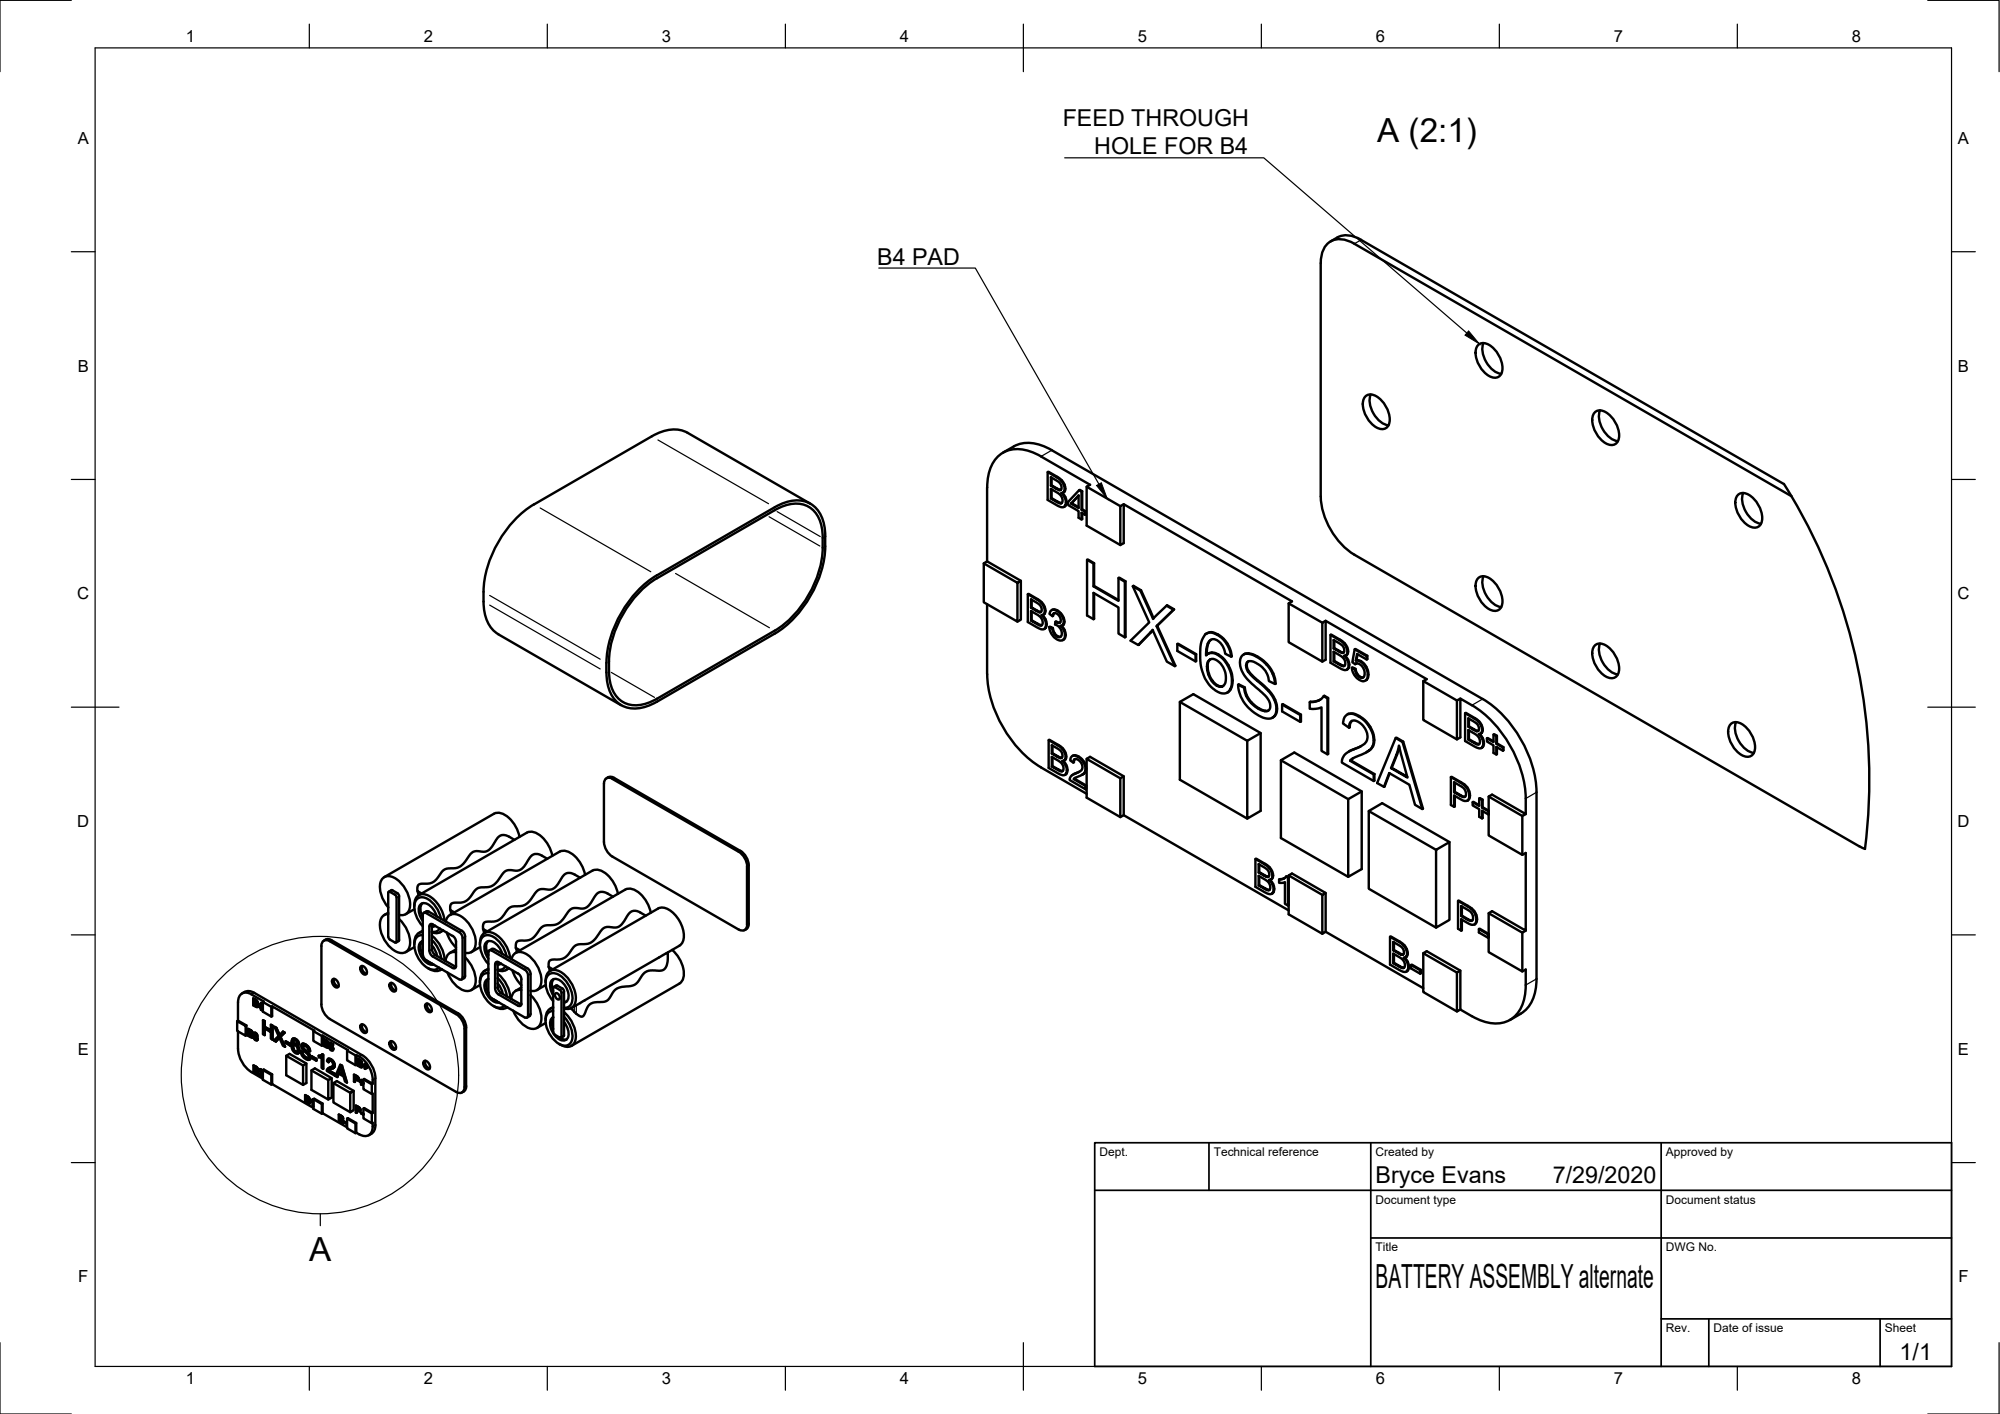
[picture p17: page 1]
A (2:1) FEED THROUGH HOLE FOR B4; B4 PAD

Dept. | Technical reference | Created by Bryce Evans 7/29/2020 | Approved by

Document type | Document status

Title BATTERY ASSEMBLY alternate | DWG No.

Rev. | Date of issue | Sheet 1/1
