airtoall/papr-eletrical/4-mill-vent/schematics-bom/schematics-complete systemv1.pdf

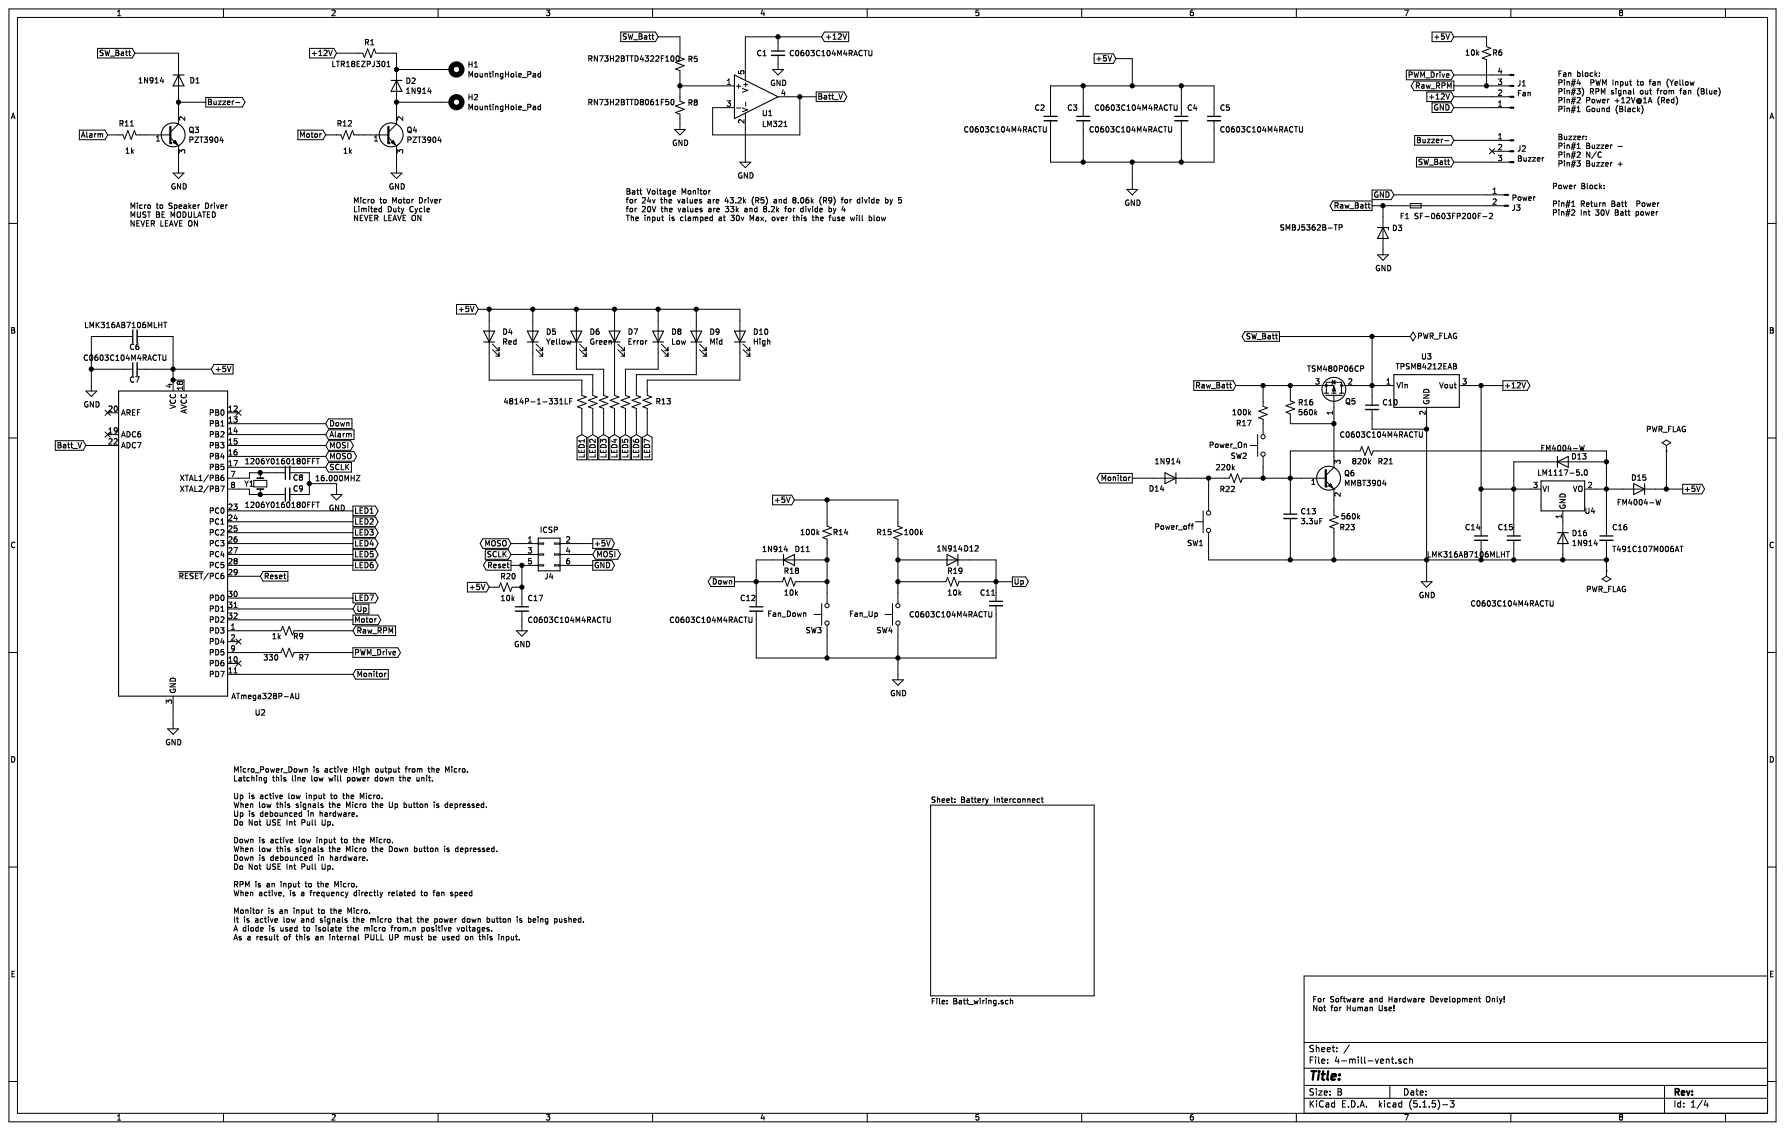
[picture p18: page 1]

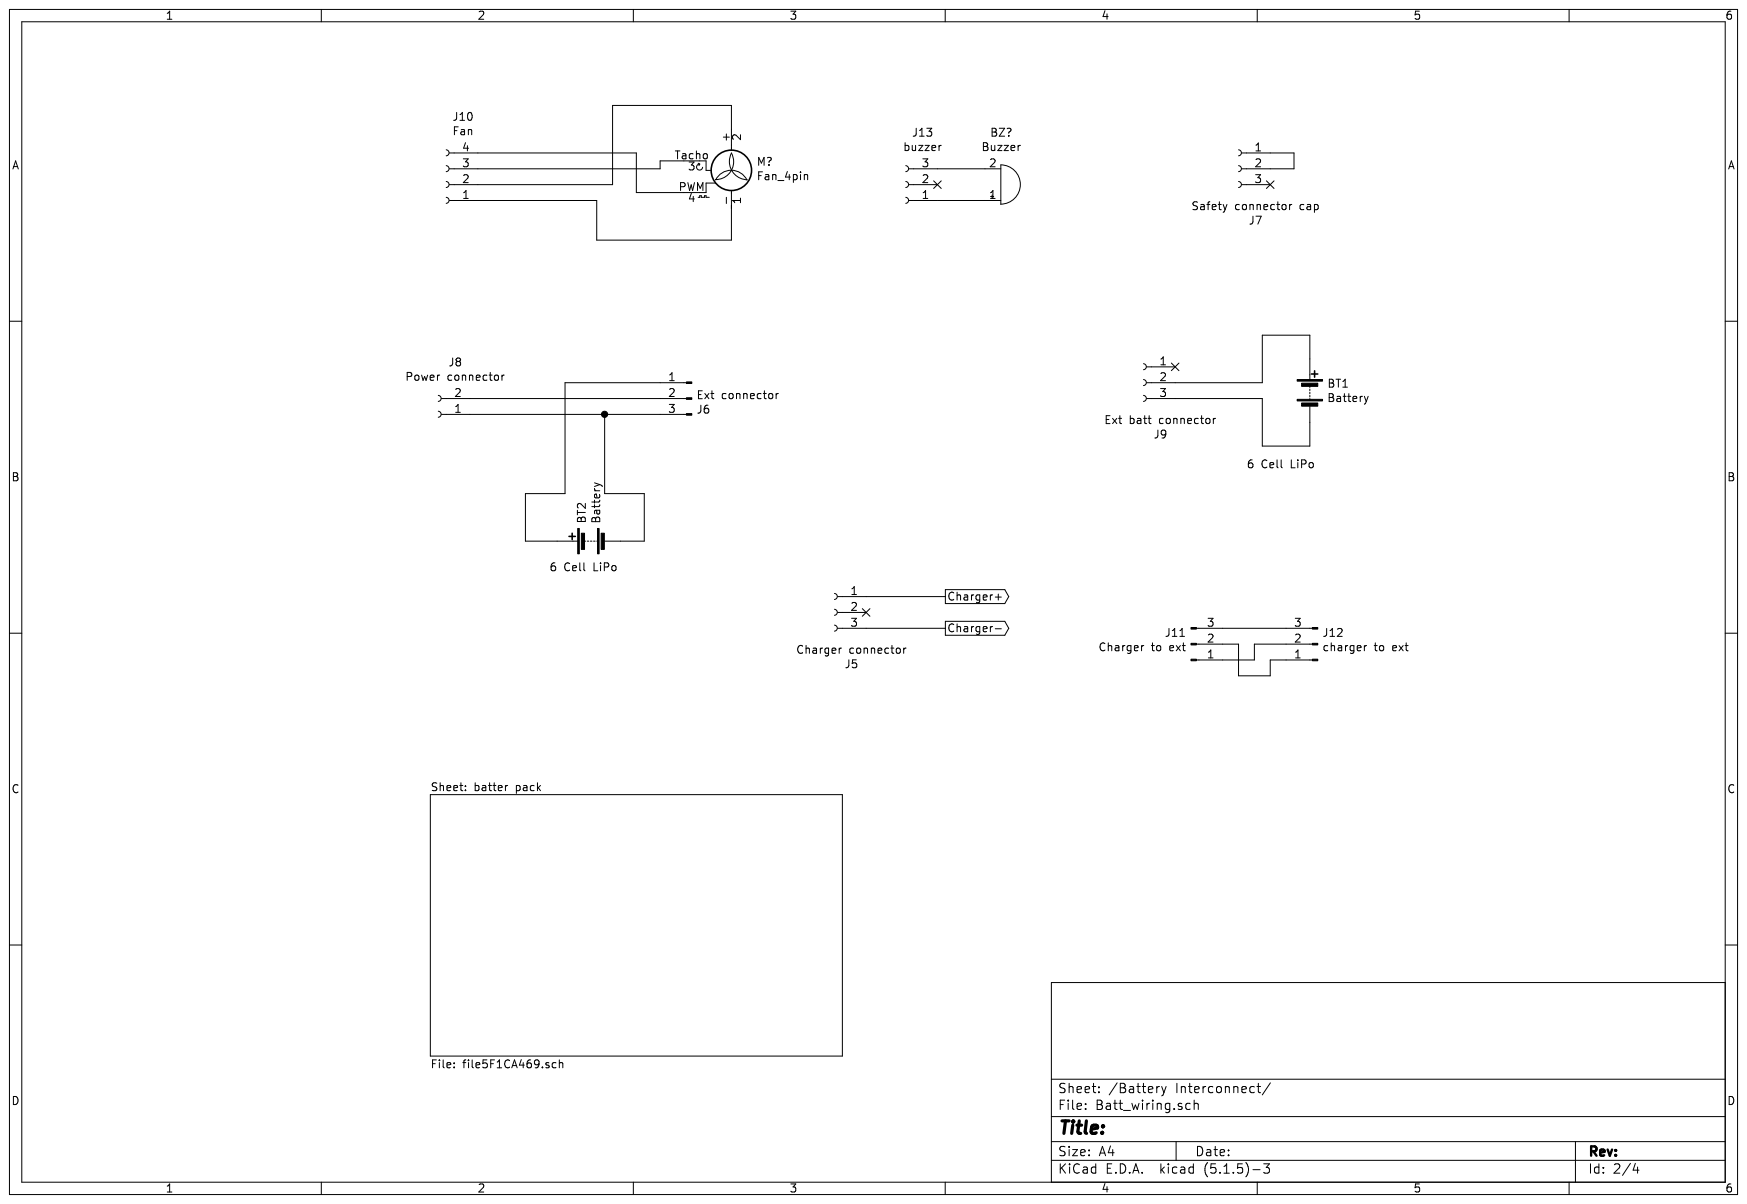
[picture p19: page 2]

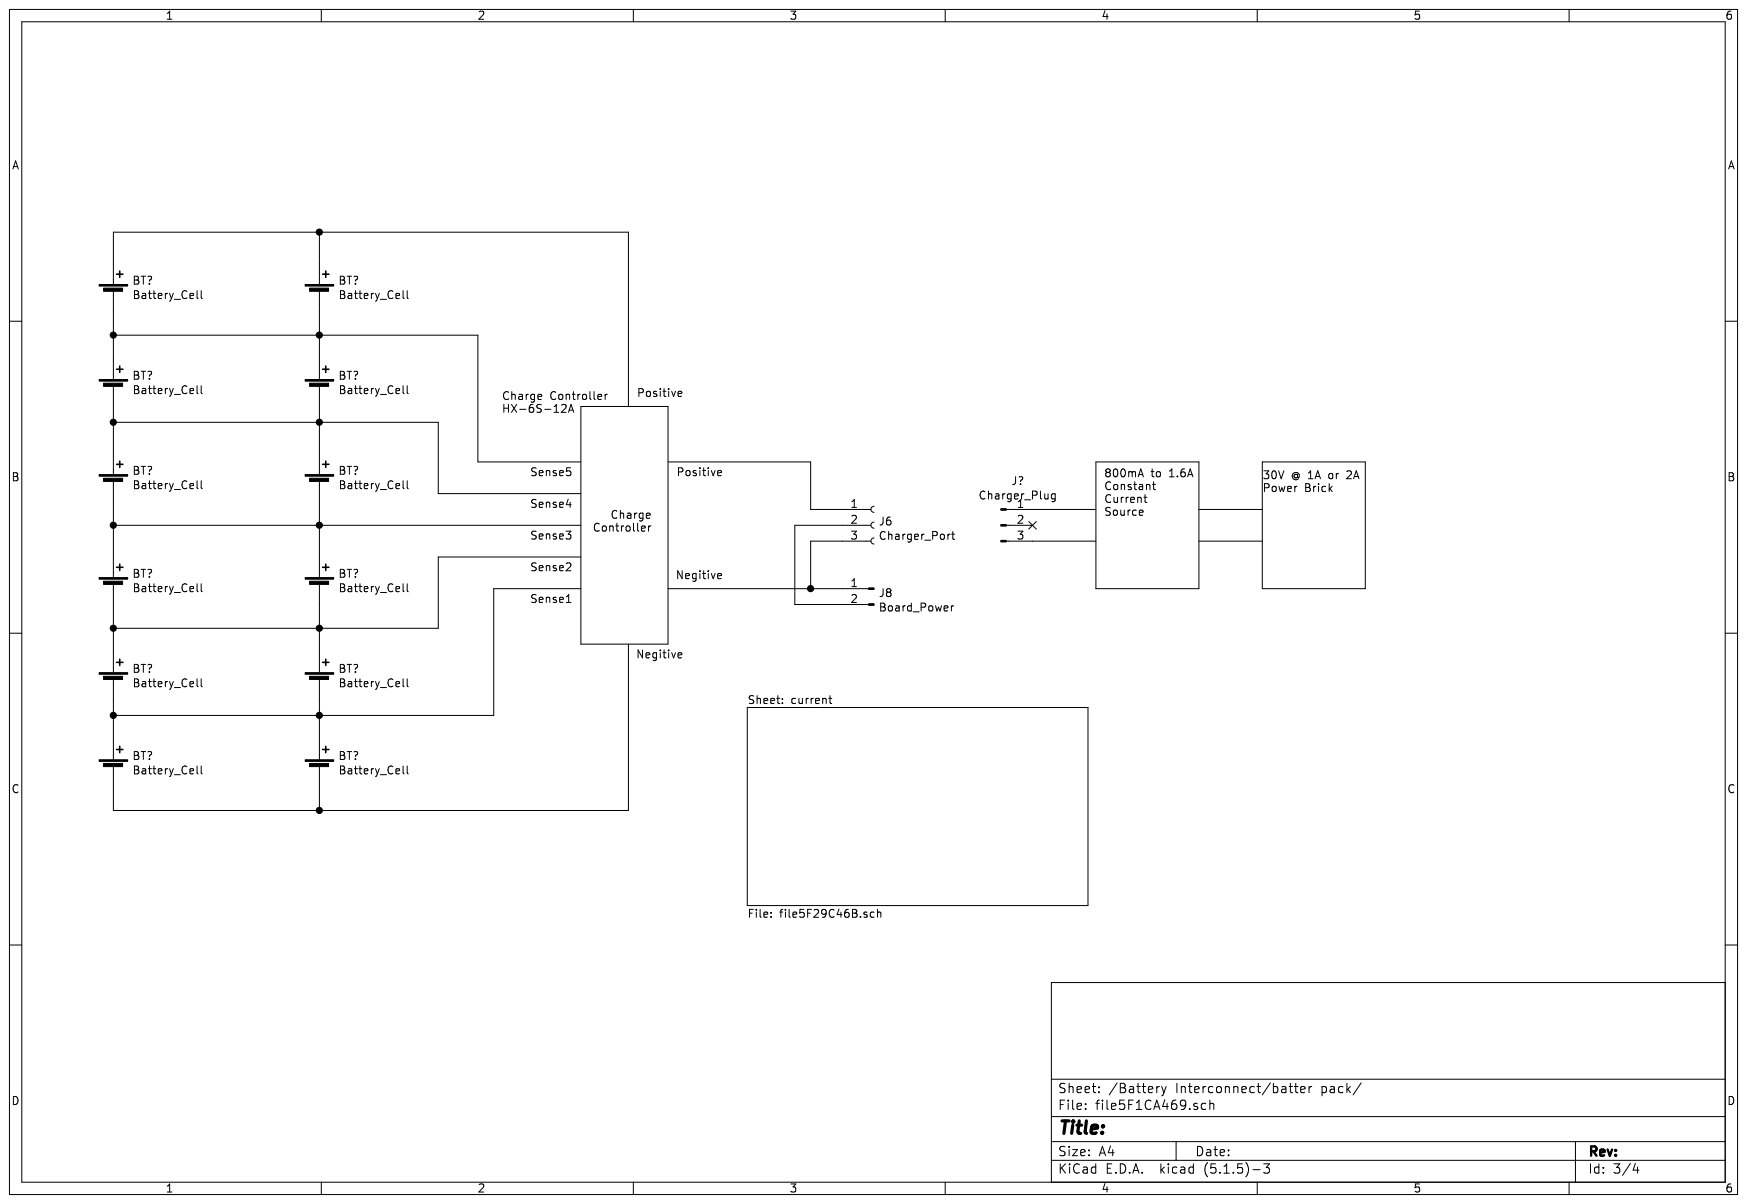
[picture p20: page 3]

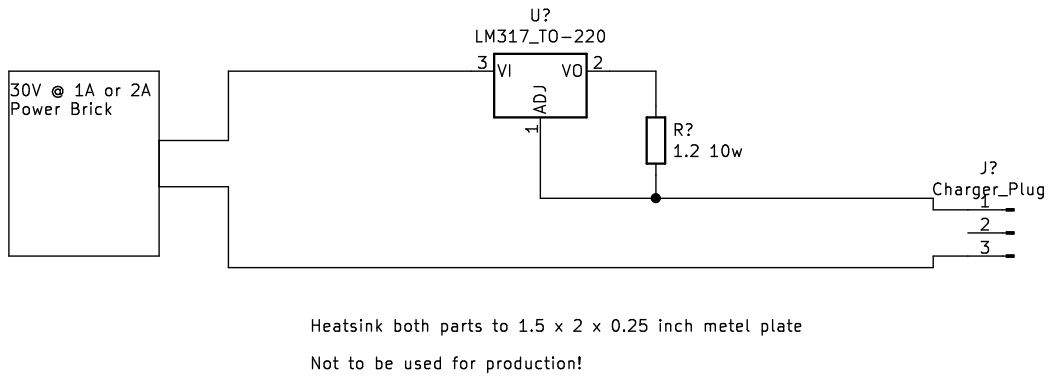
[picture p21: page 4]
