airtoall/papr-eletrical/(commit log)

2020-06-19 Checking in what @dogma2u created and shared in the channel, will clean up after baseline
    [1-mill-vent.kicad_pcb, 1-mill-vent.sch, 1-mill-vent_FP.kicad_pcb, 1-mill-vent_FP.sch]
2020-07-03 Last update to ver1, start v2
    V1 is first board
    V2 is start of SMD design
    [1-mill-vent.kicad_pcb, 1-mill-vent.sch, 1-mill-vent_FP.kicad_pcb, 2-mill-vent.kicad_pcb, 2-mill-vent.sch, 2-mill-vent_FP.kicad_pcb, 2-mill-vent_FP.sch]
2020-07-03 Path split SMD and non-SMD J1
    an SMD J1 connector maybe hard to put into production, as this makes a double sided SMD board.
    So another board was made with J1 being a THT part.
    2A is the SMD version of the Front Panel and all SMD.
    2B is a SMD verstion of the Front Panel with J1 being THT part.
    This is the Second vertion of the front panel .
    [2A-mill-vent_FP.kicad_pcb, 2A-mill-vent_FP.sch, 2B-mill-vent_FP.kicad_pcb, 2B-mill-vent_FP.sch]
2020-07-03 deleted old file
    forgot to delete old file
    [2-mill-vent_FP.kicad_pcb, 2-mill-vent_FP.sch]
2020-07-05 Made major changes to 2A and started an all in one board
    2A is a longer SMD front panel board now, no plans on updating 2b. work on 1, 2 , 2A, 2B has stoped.
    Now looking at 3 to cut cost greatly with not having to interconnect two boards and make two boards. just the parts cost savings is in the order of $30 in qty1
    [2-mill-vent.kicad_pcb, 2-mill-vent.sch, 2A-mill-vent_FP v1.step, 2A-mill-vent_FP.kicad_pcb, 2A-mill-vent_FP.step, 3-mill-vent.kicad_pcb, 3-mill-vent.sch]
2020-07-06 Just a check point
    More work done on all in one board.
    Now has step file of board with traces
    [3-mill-vent-7-5-2020-87pm v1.step, 3-mill-vent.kicad_pcb, 3-mill-vent.sch, motor v1.step]
2020-07-08 All in one board Start v4
    New all in one board with fixed points for mounting, leds, switches and keepout zones
    [4-mill-vent-7-5-2020-87pm v1.step, 4-mill-vent.kicad_pcb, 4-mill-vent.sch, motor v1.step]
2020-07-08 Save point
    Lots done, still working on some of the design so parts of micro are still up in air. Looks like this board size will for and can be made smaller
    [4-mill-vent-7-5-2020-87pm v1.step, 4-mill-vent.kicad_pcb, 4-mill-vent.step]
2020-07-08 Just pushing updates
    [4-mill-vent.kicad_pcb, 4-mill-vent.sch]
2020-07-09 Just an update on things
    update schematic to and pcb. figured out a way to user int, ext and chager over three pin connector with only to wires to PCB and no extra diode needed. getting closer to the anwers on PWM pins to use with what fuction.
    very little let to do on PCB, but things have to get checked before getting it done.
    [4-mill-vent.kicad_pcb, 4-mill-vent.sch]
2020-07-10 just keeping files up to date
    [4-mill-vent.sch]
2020-07-10 Board mainly done
    Layout is done, have things to correct and adjustments to make, but for the most part it is done.
    [4-mill-vent.kicad_pcb, 4-mill-vent.sch, Batt_wiring.sch]
2020-07-11 lastest updates to board
    Board is done, just need to do more checking
    [4-mill-vent.kicad_pcb, 4-mill-vent.sch, 4-mill-vent.step, 4-mill-vent_FIRST-COMPLETE v1.step]
2020-07-11 Added more to design
    Had to add a transitor for allow the micro to power down the unit.
    The reason is Q6's base can be as high as 16v when the on button is pressed.
    This micro does not have open collector outputs and that would blow the chip.
    [4-mill-vent.kicad_pcb, 4-mill-vent.sch, Batt_wiring.sch]
2020-07-11 Made debounce failsafe
    found a missing resistor on raw rpm pull up. other little error or problems were fixed as well. all part of normal clean up
    [4-mill-vent.kicad_pcb, 4-mill-vent.sch]
2020-07-11 more clean up
    [4-mill-vent.kicad_pcb, 4-mill-vent.sch]
2020-07-11 BOM started
    More updates to board
    [1-mill-vent.kicad_pcb, 1-mill-vent.sch, 1-mill-vent_FP.kicad_pcb, 1-mill-vent_FP.sch, 2-mill-vent.kicad_pcb, 2-mill-vent.sch, 2A-mill-vent_FP v1.step, 2A-mill-vent_FP.kicad_pcb]
2020-07-12 more updates
    Found i added a extra resistor to raw_rpm, moved a few pins around the micro.. misc. clean up
    [4-mill-vent.kicad_pcb, 4-mill-vent.sch, BOM.xlsx]
2020-07-13 Worked on moving parts around to improve ground plane
    lots of parts and trace movement re-routing to make the ground plane lbetter.
    [4-mill-vent.kicad_pcb, 4-mill-vent.sch]
2020-07-13 just making sure the lastest is pushed
    going to be doing some testing today on power down and monitor. also going to change interface with fan, as there was no problems with the design on the test board.
    [4-mill-vent.kicad_pcb, 4-mill-vent.sch]
2020-07-16 last update for this round
    last update for ver4 of board.
    next will be ver5
    [1-mill-vent.kicad_pcb, 4-mill-vent.kicad_pcb, 4-mill-vent.sch, BOM.xlsx]
2020-07-16 Create NEOTech_papr_Air_to_All.ZIP
    Added zip file with every thing needed for PCB
2020-07-17 Update NEOTech_papr_Air_to_All.ZIP
    found buzzer holes had run in to a signals line, moved line and did a litte other clean up
2020-07-17 a push so zip matches 4-mill folder
    found a bad error, all fixed now
    [4-mill-vent.kicad_pcb, BOM.xlsx]
2020-07-17 And update was missed some where along the way and a reset cap was not added to the board
    updated both zip and 4-mill-vent files so they are in sync.
    cleaned up so grounds for the micro as well
    [4-mill-vent.kicad_pcb, 4-mill-vent.sch]
2020-08-02 last push
    last push with more detail
    [1-mill-vent.kicad_pcb, 1-mill-vent.sch, 1-mill-vent_FP.kicad_pcb, 1-mill-vent_FP.sch, 2-mill-vent.kicad_pcb, 2-mill-vent.sch, 2A-mill-vent_FP v1.step, 2A-mill-vent_FP.kicad_pcb]
2020-08-18 Updated board and wrote test firmware
    Testing of ver1 board looks good, waiting on opamp to test batt. wrote test firmware to test leds, switches and pwm on fan. power supply working. need to test batt monitor, buzzer and motor. every thing else seems fine.
    board Ver2 started, added diff opamp for batt to get a wider spin for monitoring. May add F/v for fan speed.
    [4-mill-vent.kicad_pcb, 4-mill-vent.sch, Batt_wiring.sch, file5F1CA469.sch, file5F29C46B.sch]
2020-09-05 Last Update USE V2
    Board test complete, all slikscreen error are fixed in v2, Full use of opamp for battery monitoring.
    [4-mill-vent-B_Adhes.gbr, 4-mill-vent-B_Cu.gbr, 4-mill-vent-B_Mask.gbr, 4-mill-vent-B_Paste.gbr, 4-mill-vent-B_SilkS.gbr, 4-mill-vent-Edge_Cuts.gbr, 4-mill-vent-F_Adhes.gbr, 4-mill-vent-F_Cu.gbr]
2020-12-18 Adding updated bom with lead times from Braulio
    [ATA_PCBA_V3_Leadtime_Stock_Review - 12-11-2020.xlsx]
